Sebastiangomez94/PINV01-819/Diseños 3D/pixhawk4c_support.SLDASM

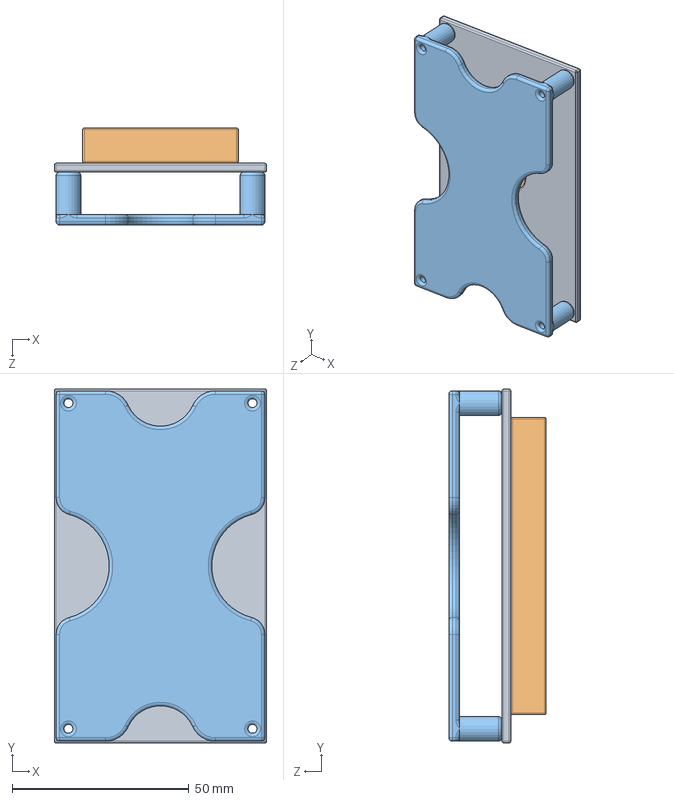
[picture p6: CAD file, 2026-10-13]
Diseños 3D/pixhawk4c_support.SLDASM
60.0 x 100.0 x 27.5 mm
pixhawk4c_support_up
pixhawk4c
pixhawk4c_support_down
