Sebastiangomez94/PINV01-819/Diseños 3D/battplate_pillar.SLDPRT

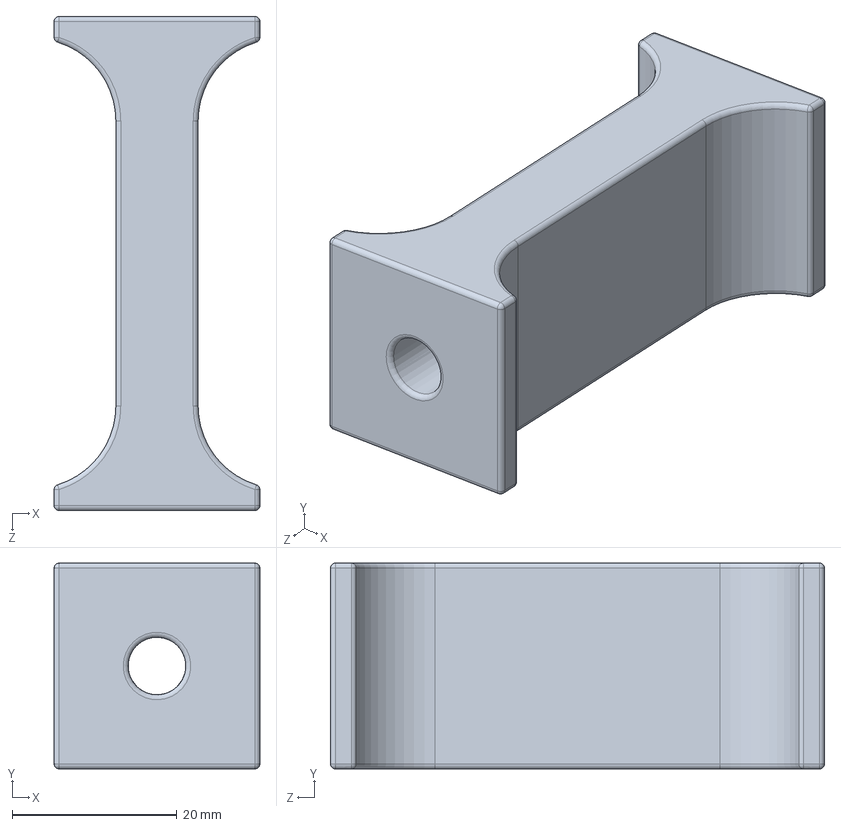
[picture p7: CAD file, 2026-10-13]
Diseños 3D/battplate_pillar.SLDPRT
25.0 x 25.0 x 60.0 mm
