Sebastiangomez94/PINV01-819/Diseños 3D/Diseños anteriores/GPS_holder_v1.SLDPRT

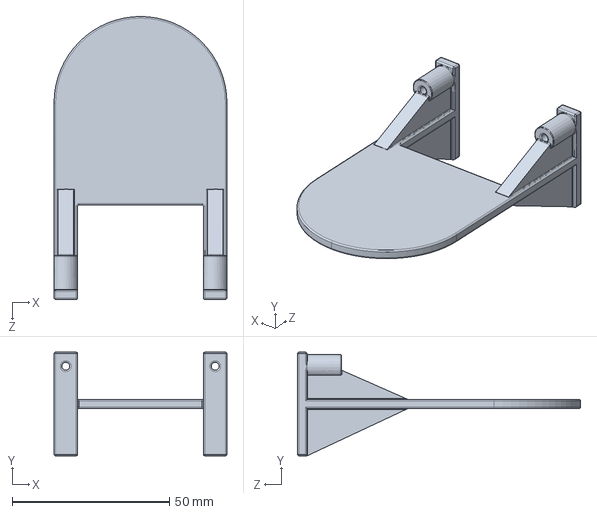
[picture p8: CAD file, 2026-10-13]
Diseños 3D/Diseños anteriores/GPS_holder_v1.SLDPRT
55.0 x 33.0 x 90.0 mm
