Sebastiangomez94/PINV01-819/Diseños 3D/rpi3b_support.SLDPRT

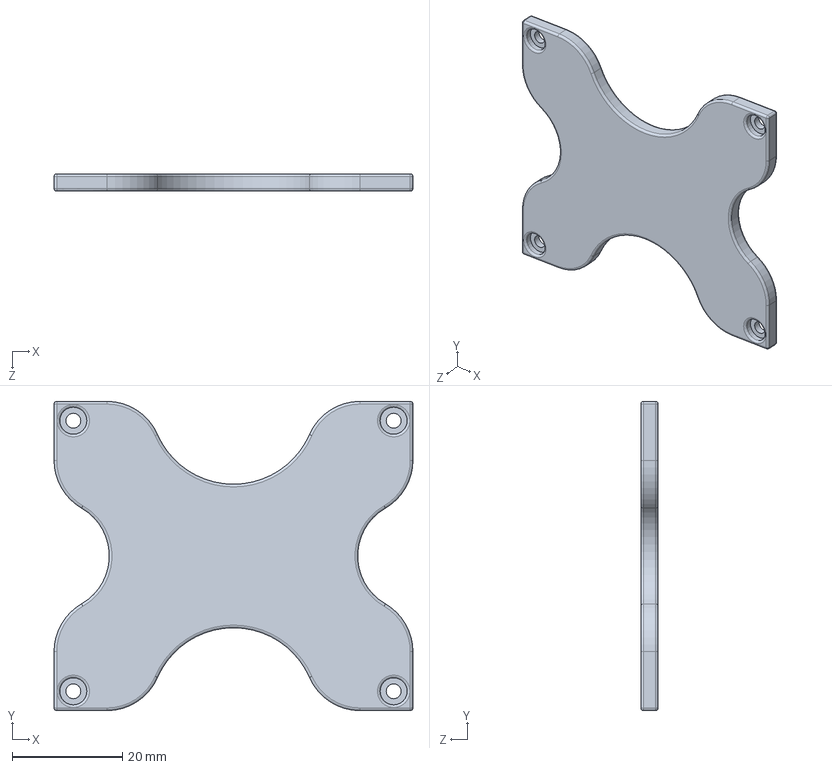
[picture p9: CAD file, 2026-10-13]
Diseños 3D/rpi3b_support.SLDPRT
65.0 x 56.0 x 3.16 mm
