Sebastiangomez94/PINV01-819/Diseños 3D/GPS_holder.SLDPRT

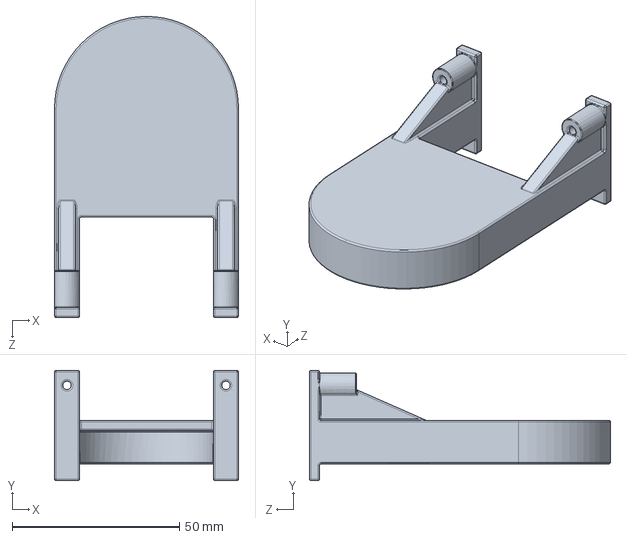
[picture p10: CAD file, 2026-10-13]
Diseños 3D/GPS_holder.SLDPRT
55.0 x 33.0 x 90.0 mm
