Sebastiangomez94/PINV01-819/Diseños 3D/PM07_support.SLDPRT

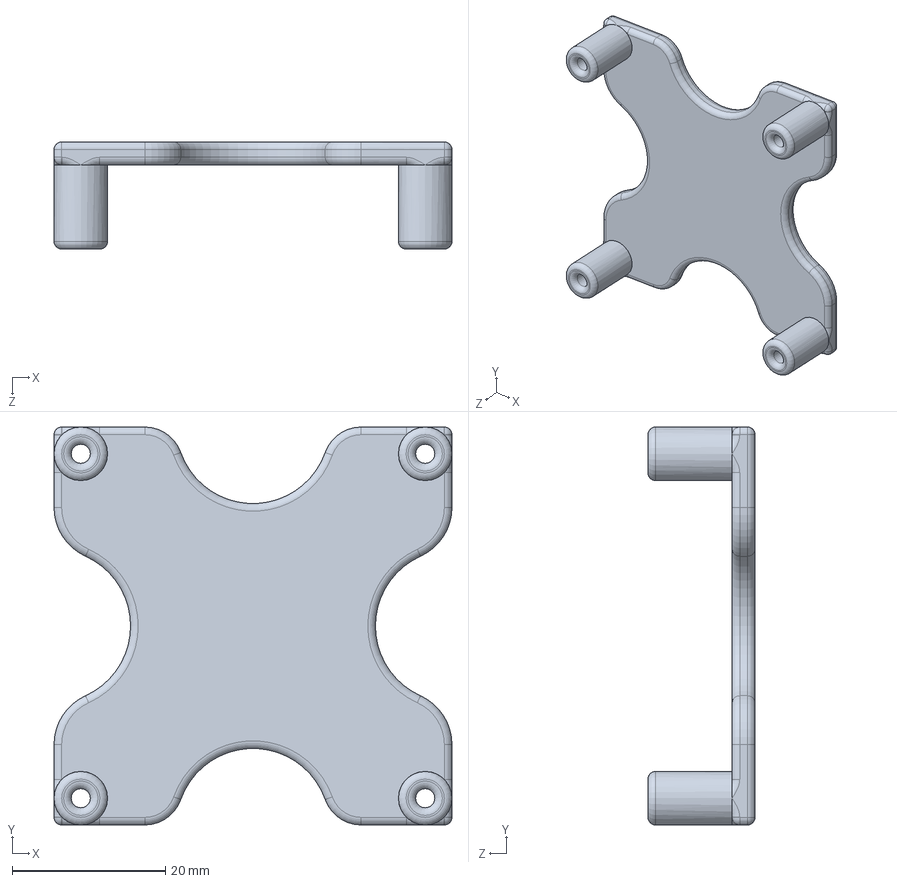
[picture p11: CAD file, 2026-10-13]
Diseños 3D/PM07_support.SLDPRT
52.0 x 52.0 x 14.0 mm
