Sebastiangomez94/PINV01-819/Diseños 3D/battplate_bandaid.SLDPRT

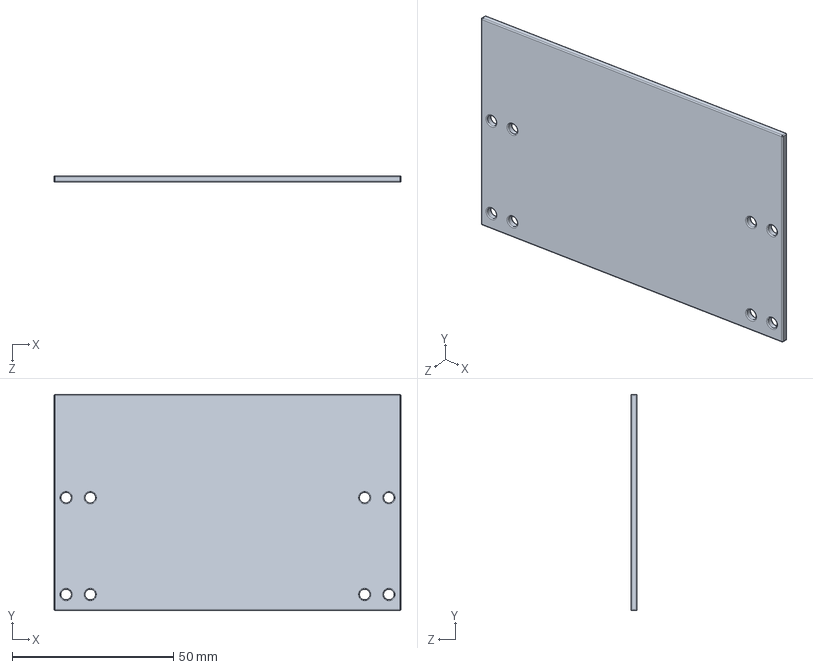
[picture p12: CAD file, 2026-10-13]
Diseños 3D/battplate_bandaid.SLDPRT
107.5 x 67.0 x 2.00 mm
