Sebastiangomez94/PINV01-819/Diseños 3D/pixhawk4c_support_down.SLDPRT

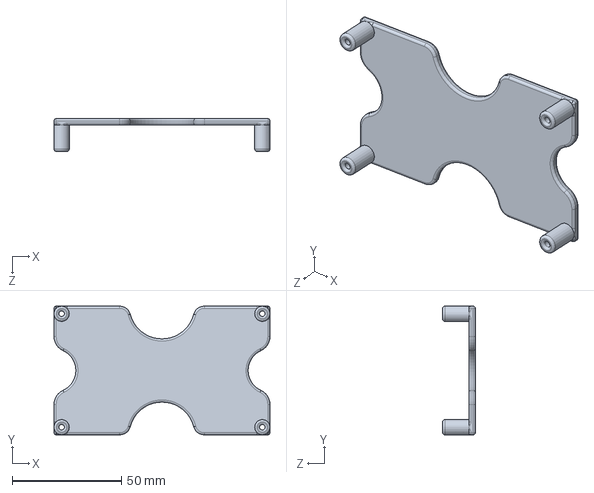
[picture p13: CAD file, 2026-10-13]
Diseños 3D/pixhawk4c_support_down.SLDPRT
99.0 x 59.0 x 15.0 mm
