Sebastiangomez94/PINV01-819/Diseños 3D/breaker_rail_stop.SLDPRT

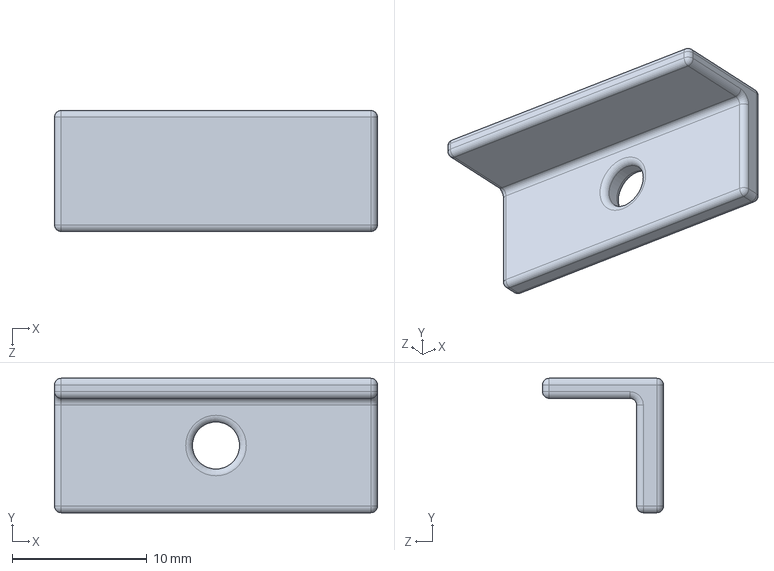
[picture p14: CAD file, 2026-10-13]
Diseños 3D/breaker_rail_stop.SLDPRT
24.0 x 10.0 x 9.00 mm
