Sebastiangomez94/PINV01-819/Diseños 3D/battery_holder.SLDPRT

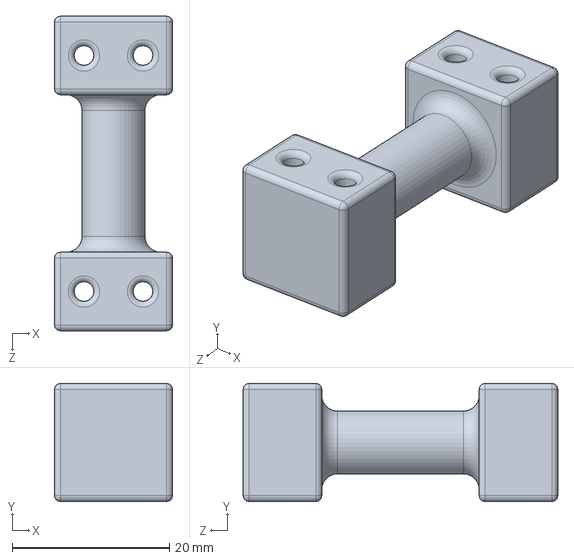
[picture p15: CAD file, 2026-10-13]
Diseños 3D/battery_holder.SLDPRT
15.0 x 15.0 x 40.0 mm
