Sebastiangomez94/PINV01-819/Diseños 3D/pixhawk4c_support_up.SLDPRT

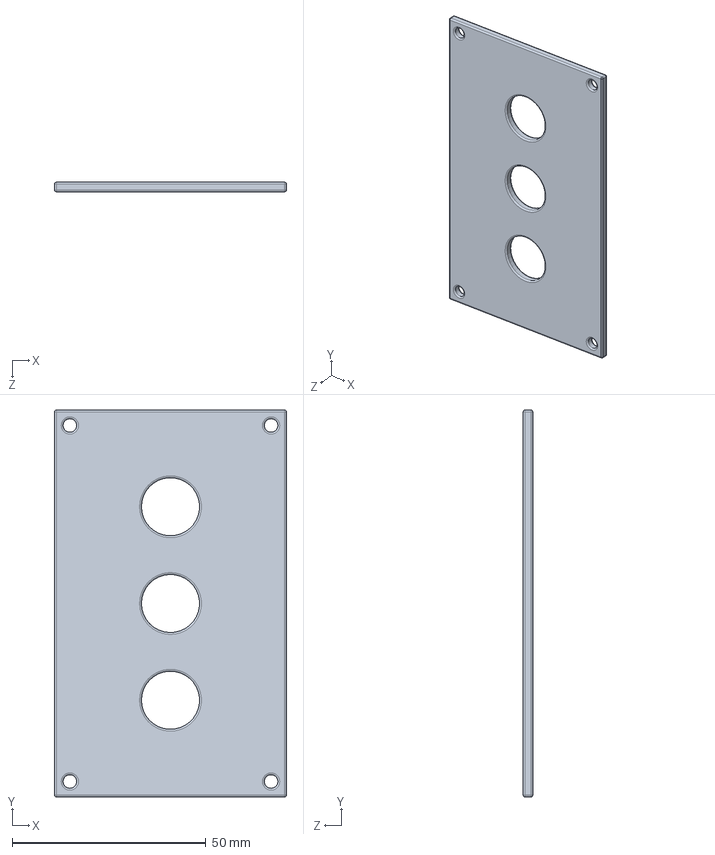
[picture p16: CAD file, 2026-10-13]
Diseños 3D/pixhawk4c_support_up.SLDPRT
60.0 x 100.0 x 2.50 mm
