Sebastiangomez94/PINV01-819/Diseños 3D/adaptador_lampara_escalera.SLDPRT

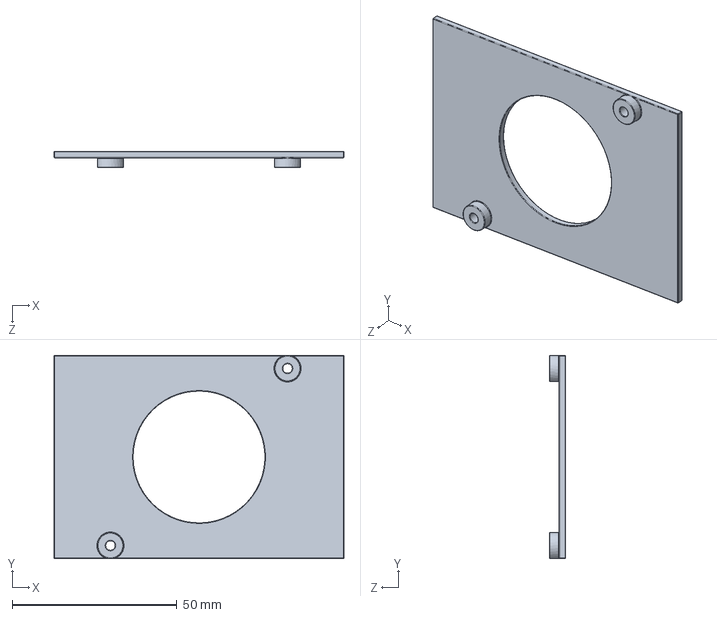
[picture p17: CAD file, 2026-10-13]
Diseños 3D/adaptador_lampara_escalera.SLDPRT
88.0 x 61.6 x 5.00 mm
