Sebastiangomez94/PINV01-819/Diseños 3D/pixhawk4c.SLDPRT

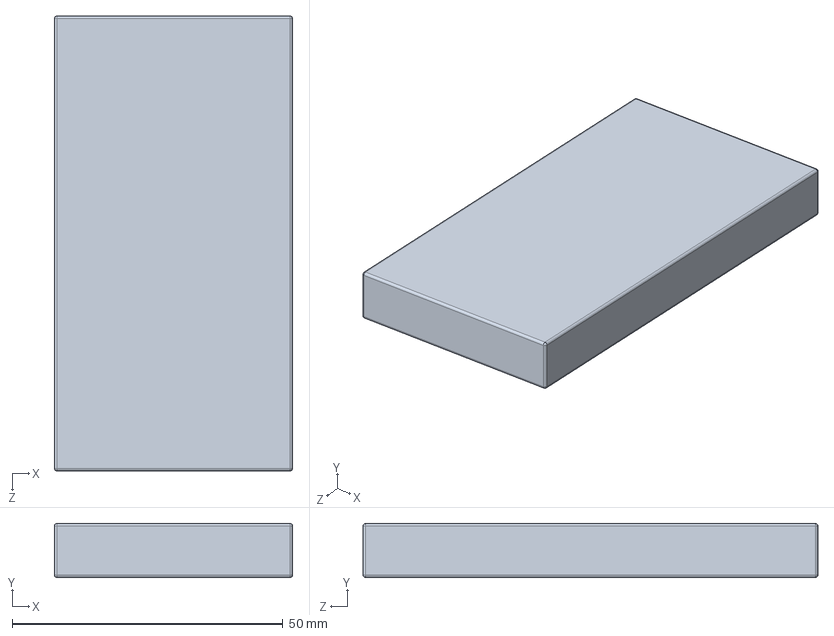
[picture p18: CAD file, 2026-10-13]
Diseños 3D/pixhawk4c.SLDPRT
44.0 x 10.0 x 84.0 mm
