Sebastiangomez94/PINV01-819/Diseños 3D/NotecarrierB_support.SLDPRT

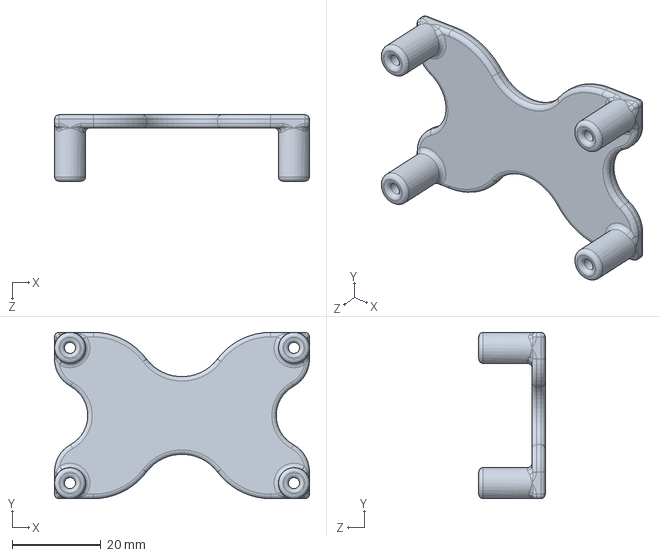
[picture p19: CAD file, 2026-10-13]
Diseños 3D/NotecarrierB_support.SLDPRT
57.5 x 37.5 x 15.0 mm
