Sebastiangomez94/PINV01-819/Diseños 3D/battplate_screw_holder.SLDPRT

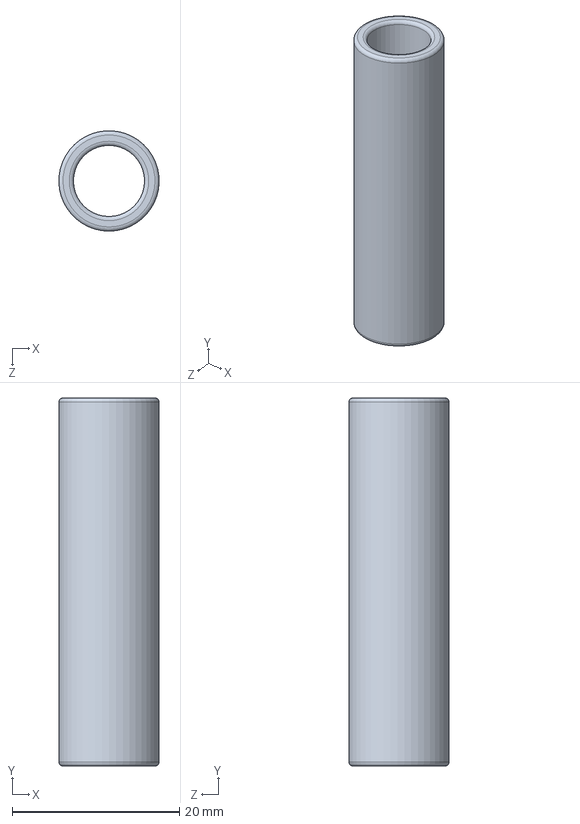
[picture p20: CAD file, 2026-10-13]
Diseños 3D/battplate_screw_holder.SLDPRT
12.0 x 44.0 x 12.0 mm
