Sebastiangomez94/PINV01-819/Diseños 3D/battplate_washer.SLDPRT

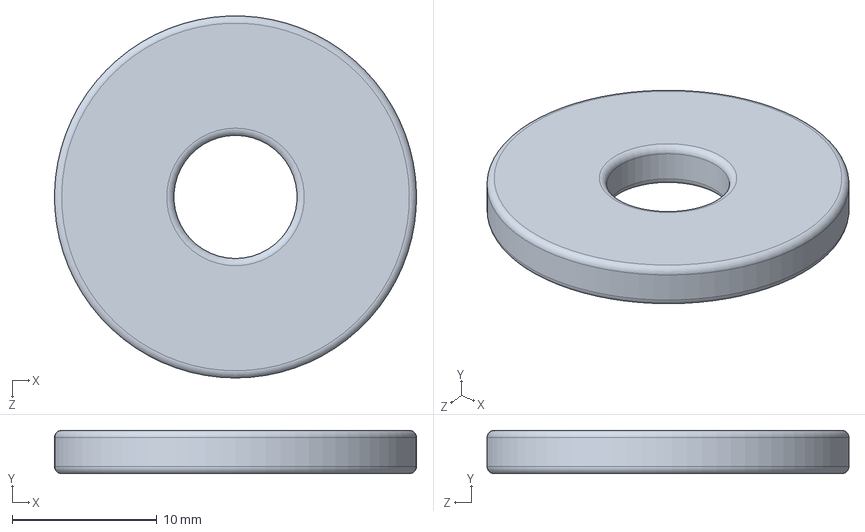
[picture p21: CAD file, 2026-10-13]
Diseños 3D/battplate_washer.SLDPRT
25.0 x 3.00 x 25.0 mm
