Sebastiangomez94/PINV01-819/Diseños 3D/Diseños anteriores/GPS_holder_v0.SLDPRT

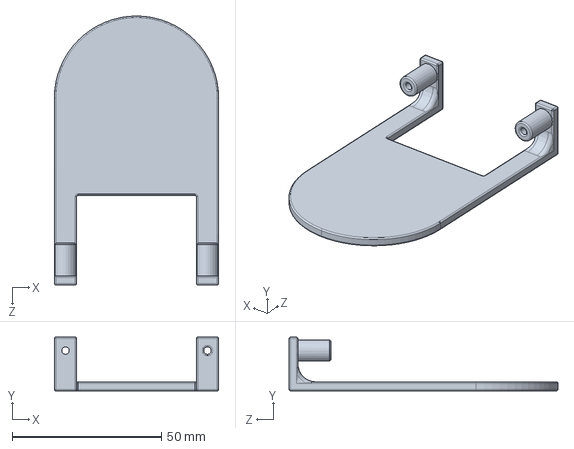
[picture p23: CAD file, 2026-10-13, an earlier design]
Diseños 3D/Diseños anteriores/GPS_holder_v0.SLDPRT
55.0 x 18.0 x 90.0 mm
