Sebastiangomez94/PINV01-819/(list of files, cad)

Other CAD files:
Diseños 3D/GPS_holder.STL
Diseños 3D/NotecarrierB_support.STL
Diseños 3D/PM07_support.STL
Diseños 3D/battery_holder.STL
Diseños 3D/battplate_bandaid.STL
Diseños 3D/battplate_pillar.STL
Diseños 3D/battplate_screw_holder.STL
Diseños 3D/battplate_washer.STL
Diseños 3D/breaker_rail_stop.STL
Diseños 3D/electronicsbox_washer.STL
Diseños 3D/pixhawk4c_support_down.STL
Diseños 3D/pixhawk4c_support_up.STL
Diseños 3D/rpi3b_support.STL
