Sebastiangomez94/PINV01-819/ruta de prueba/readme.txt

El archivo .ulg puede ser procesado mediante la herramienta ulog2csv. Para usarla, instalar pyulog previamente. 

Tras ello, se generan archivos .csv, de los cuales se deberan utilizar los archivos en el que su nombre incluya 'vehicle_global_position' y 'rover_position_setpoint'. 

Se puede utilizar Gemini Notebook para generar un KML con la ruta deseada y hecha mediante los dos .csv previamente mencionados.
