Sebastiangomez94/PINV01-819/Firware PX4/backup_parametros_asv1.params

1	1	BAT1_A_PER_V	0	9
1	1	BAT1_CAPACITY	-1	9
1	1	BAT1_I_CHANNEL	-1	6
1	1	BAT1_I_OVERWRITE	0	9
1	1	BAT1_N_CELLS	4	6
1	1	BAT1_R_INTERNAL	-1	9
1	1	BAT1_SOURCE	-1	6
1	1	BAT1_V_CHANNEL	-1	6
1	1	BAT1_V_CHARGED	4.2	9
1	1	BAT1_V_DIV	18.214836	9
1	1	BAT1_V_EMPTY	3.7	9
1	1	BAT2_A_PER_V	36.367516	9
1	1	BAT2_CAPACITY	-1	9
1	1	BAT2_I_CHANNEL	-1	6
1	1	BAT2_I_OVERWRITE	0	9
1	1	BAT2_N_CELLS	4	6
1	1	BAT2_R_INTERNAL	-1	9
1	1	BAT2_SOURCE	0	6
1	1	BAT2_V_CHANNEL	-1	6
1	1	BAT2_V_CHARGED	4.2	9
1	1	BAT2_V_DIV	18.282173	9
1	1	BAT2_V_EMPTY	3.7	9
1	1	BAT_AVRG_CURRENT	15	9
1	1	BAT_CRIT_THR	0.07	9
1	1	BAT_EMERGEN_THR	0.05	9
1	1	BAT_LOW_THR	0.15	9
1	1	BAT_V_OFFS_CURR	0	9
1	1	CA_AIRFRAME	6	6
1	1	MOT_POLE_COUNT	14	6
1	1	PWM_MAIN_DIS1	1500	6
1	1	PWM_MAIN_DIS2	1500	6
1	1	PWM_MAIN_DIS3	1000	6
1	1	PWM_MAIN_DIS4	1000	6
1	1	PWM_MAIN_DIS5	1000	6
1	1	PWM_MAIN_DIS6	1000	6
1	1	PWM_MAIN_DIS7	1000	6
1	1	PWM_MAIN_DIS8	1000	6
1	1	PWM_MAIN_FAIL1	-1	6
1	1	PWM_MAIN_FAIL2	-1	6
1	1	PWM_MAIN_FAIL3	-1	6
1	1	PWM_MAIN_FAIL4	-1	6
1	1	PWM_MAIN_FAIL5	-1	6
1	1	PWM_MAIN_FAIL6	-1	6
1	1	PWM_MAIN_FAIL7	-1	6
1	1	PWM_MAIN_FAIL8	-1	6
1	1	PWM_MAIN_FUNC1	102	6
1	1	PWM_MAIN_FUNC2	101	6
1	1	PWM_MAIN_FUNC3	0	6
1	1	PWM_MAIN_FUNC4	0	6
1	1	PWM_MAIN_FUNC5	0	6
1	1	PWM_MAIN_FUNC6	0	6
1	1	PWM_MAIN_FUNC7	0	6
1	1	PWM_MAIN_FUNC8	0	6
1	1	PWM_MAIN_MAX1	1900	6
1	1	PWM_MAIN_MAX2	1900	6
1	1	PWM_MAIN_MAX3	2000	6
1	1	PWM_MAIN_MAX4	2000	6
1	1	PWM_MAIN_MAX5	2000	6
1	1	PWM_MAIN_MAX6	2000	6
1	1	PWM_MAIN_MAX7	2000	6
1	1	PWM_MAIN_MAX8	2000	6
1	1	PWM_MAIN_MIN1	1100	6
1	1	PWM_MAIN_MIN2	1100	6
1	1	PWM_MAIN_MIN3	1000	6
1	1	PWM_MAIN_MIN4	1000	6
1	1	PWM_MAIN_MIN5	1000	6
1	1	PWM_MAIN_MIN6	1000	6
1	1	PWM_MAIN_MIN7	1000	6
1	1	PWM_MAIN_MIN8	1000	6
1	1	PWM_MAIN_TIM0	-1	6
1	1	PWM_MAIN_TIM1	400	6
1	1	PWM_MAIN_TIM2	400	6
1	1	SYS_AUTOSTART	50000	6
